Gabriel29062001/Bidirectional-Tactile-Interface-Control-and-Perception-Strategies/Vicon_measurement/240523_gabriel_exp_3.csv

Frame | Sub Frame | RX | RY | RZ | TX | TY | TZ | RX | RY | RZ | TX | TY | TZ
1 | 0 | 0.988768 | 2.604380 | 2.088757 | -96.686523 | 227.046860 | 127.809944 | 0.944727 | 2.256377 | 2.159344 | 147.682755 | 216.008286 | 125.660286
2 | 0 | 0.988643 | 2.604290 | 2.088892 | -96.686348 | 227.045258 | 127.800438 | 0.944832 | 2.256334 | 2.159309 | 147.679260 | 216.007538 | 125.663162
3 | 0 | 0.988755 | 2.604289 | 2.088911 | -96.684807 | 227.044479 | 127.799911 | 0.944727 | 2.256303 | 2.159403 | 147.683777 | 216.006836 | 125.659149
4 | 0 | 0.988804 | 2.604220 | 2.088839 | -96.683823 | 227.046249 | 127.796692 | 0.944715 | 2.256321 | 2.159283 | 147.681137 | 216.008423 | 125.658142
5 | 0 | 0.989229 | 2.604267 | 2.088994 | -96.681938 | 227.046631 | 127.794952 | 0.944583 | 2.256411 | 2.159188 | 147.685181 | 216.008545 | 125.654533
6 | 0 | 0.988538 | 2.604269 | 2.088599 | -96.683662 | 227.046432 | 127.795784 | 0.944751 | 2.256330 | 2.159382 | 147.683777 | 216.008560 | 125.650108
7 | 0 | 0.988817 | 2.604276 | 2.088816 | -96.684525 | 227.044754 | 127.790215 | 0.944583 | 2.256353 | 2.159317 | 147.683014 | 216.009735 | 125.655502
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
