Gabriel29062001/Bidirectional-Tactile-Interface-Control-and-Perception-Strategies/Vicon_measurement/240523_gabriel_exp_4.csv

Frame | Sub Frame | RX | RY | RZ | TX | TY | TZ | RX | RY | RZ | TX | TY | TZ
1 | 0 | 0.851712 | 2.595535 | 2.050237 | -100.426010 | 227.204132 | 130.393311 | 0.983153 | 2.164768 | 2.187362 | 133.753601 | 222.849655 | 127.206100
2 | 0 | 0.851537 | 2.595595 | 2.050010 | -100.427620 | 227.211288 | 130.400589 | 0.982895 | 2.164763 | 2.187359 | 133.751724 | 222.851730 | 127.213570
3 | 0 | 0.851709 | 2.595474 | 2.050247 | -100.431030 | 227.211060 | 130.397934 | 0.983011 | 2.164757 | 2.187290 | 133.746078 | 222.852280 | 127.212929
4 | 0 | 0.851563 | 2.595574 | 2.049980 | -100.431992 | 227.211838 | 130.399353 | 0.983066 | 2.164786 | 2.187293 | 133.745743 | 222.848175 | 127.207275
5 | 0 | 0.851496 | 2.595472 | 2.050082 | -100.431984 | 227.208984 | 130.394638 | 0.983187 | 2.164792 | 2.187349 | 133.747299 | 222.850052 | 127.210304
6 | 0 | 0.851566 | 2.595551 | 2.049965 | -100.432899 | 227.211258 | 130.399445 | 0.983196 | 2.164716 | 2.187500 | 133.747543 | 222.853439 | 127.212166
7 | 0 | 0.851105 | 2.595457 | 2.050081 | -100.430527 | 227.212021 | 130.396057 | 0.983014 | 2.164722 | 2.187463 | 133.749008 | 222.852325 | 127.204834
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
